hongdatchy/BTL-Dien-tu-tuong-tu-1/(list of files, drawings)

Other design files:
datt.pdsprj
