hongdatchy/BTL-Dien-tu-tuong-tu-1/(commit log)

2020-06-01 push all file
    [datt.pdsprj]
2020-06-03 push lai lan 2
    [datt.pdsprj]
